Enoch36Yi/FumeHoods/previews/SashSense_node1_schematic.jpg

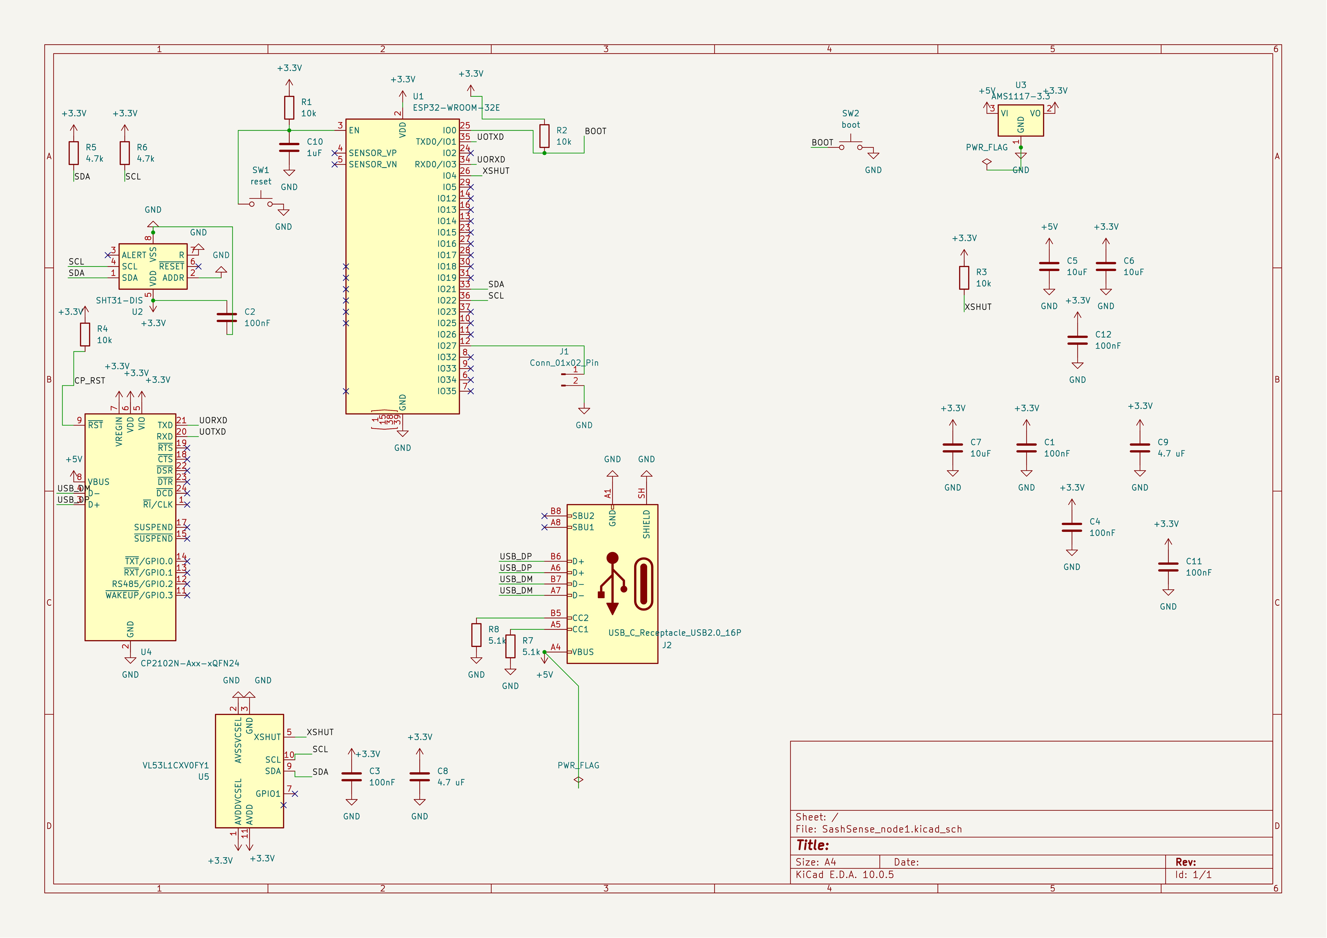
previews/SashSense_node1_schematic.jpg
