Enoch36Yi/FumeHoods/previews/SashSense_node2_pcb_3d_full.jpg

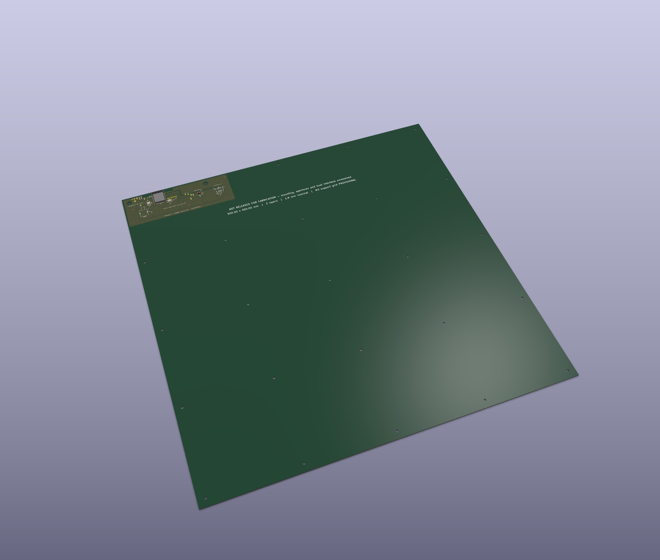
previews/SashSense_node2_pcb_3d_full.jpg
