Enoch36Yi/FumeHoods/previews/SashSense_node2_schematic.jpg

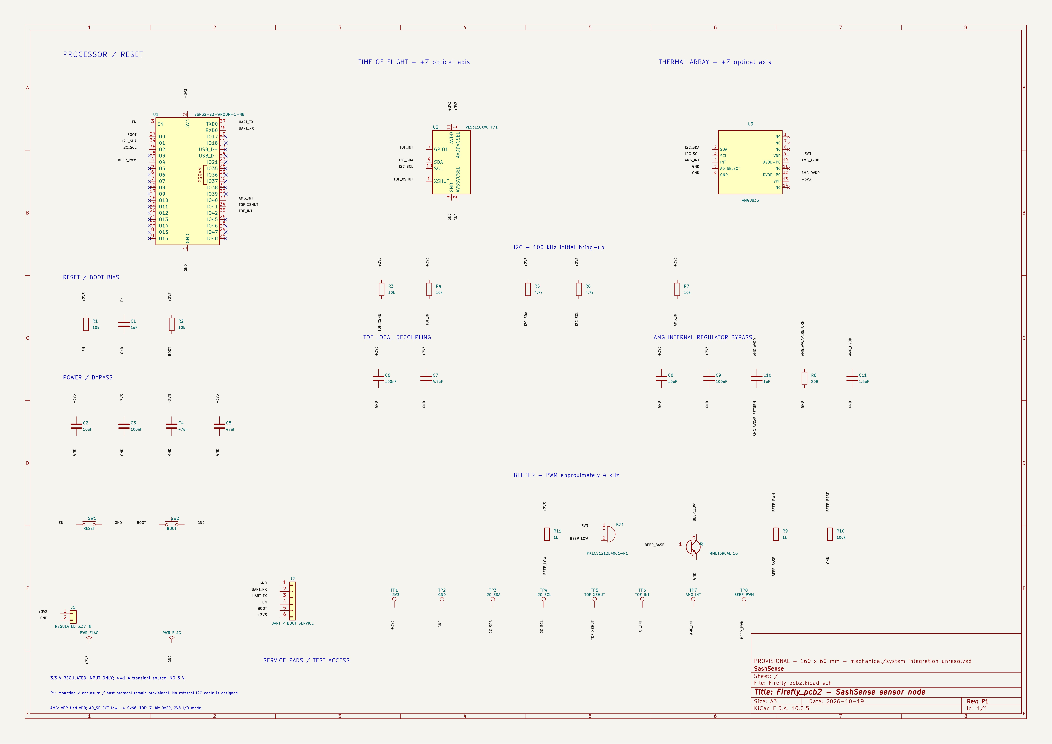
previews/SashSense_node2_schematic.jpg
