Enoch36Yi/FumeHoods/SashSense_node2/outputs/previews/Firefly_pcb2_3D_top_populated.png

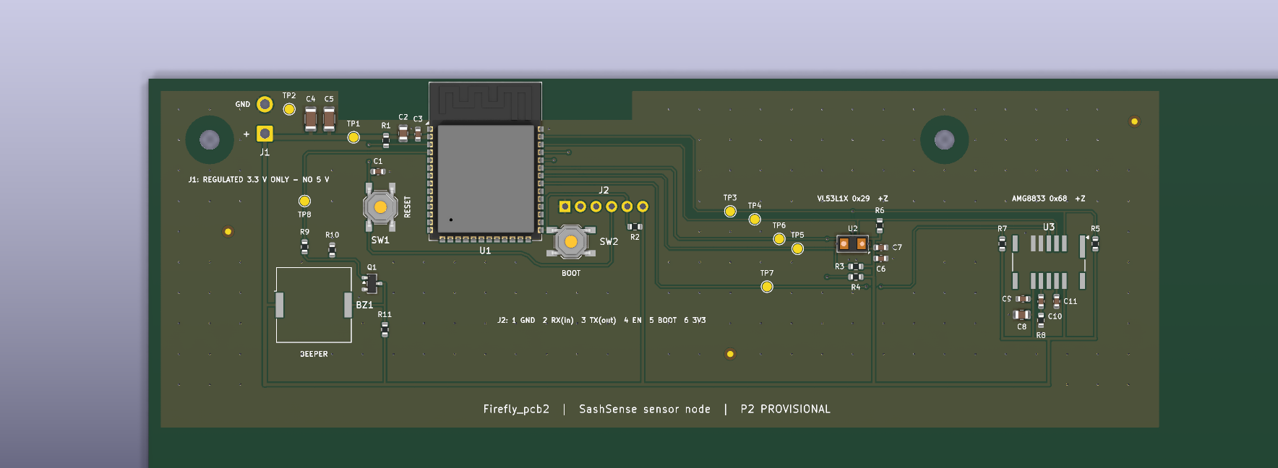
SashSense_node2/outputs/previews/Firefly_pcb2_3D_top_populated.png
