Enoch36Yi/FumeHoods/SashSense_node2/outputs/previews/Firefly_pcb2_copper_bottom.png

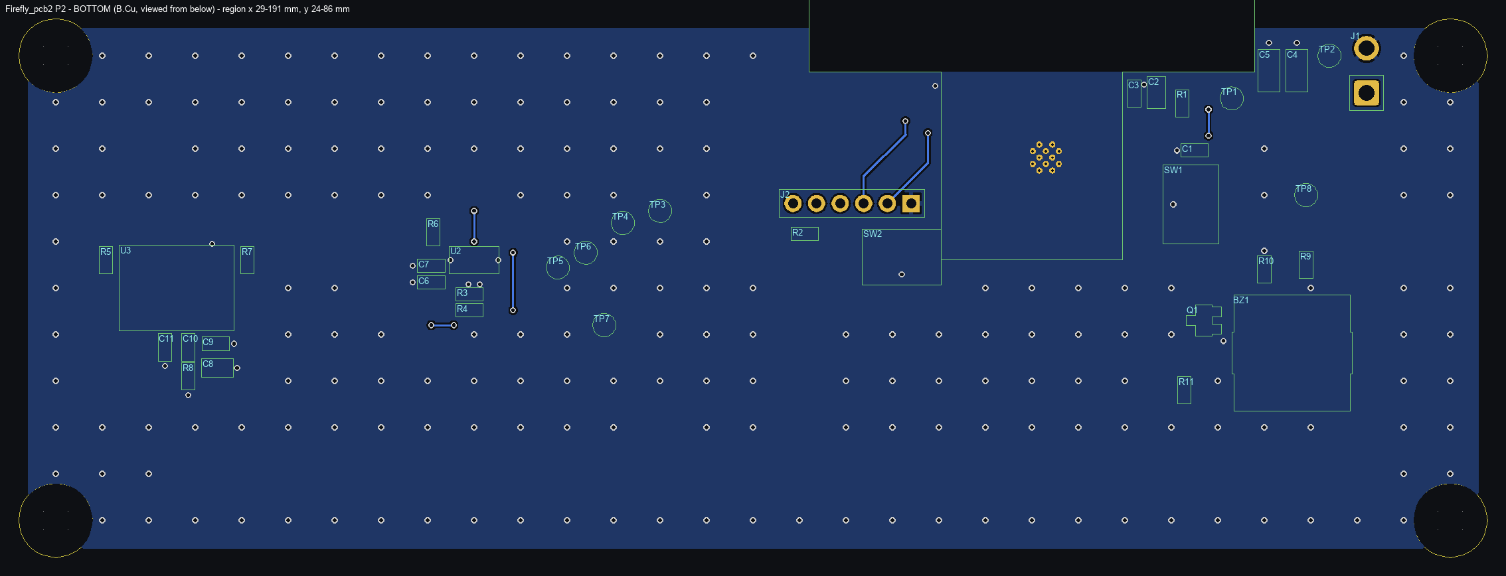
SashSense_node2/outputs/previews/Firefly_pcb2_copper_bottom.png
