Enoch36Yi/FumeHoods/SashSense_node2/outputs/Firefly_pcb2_schematic.pdf

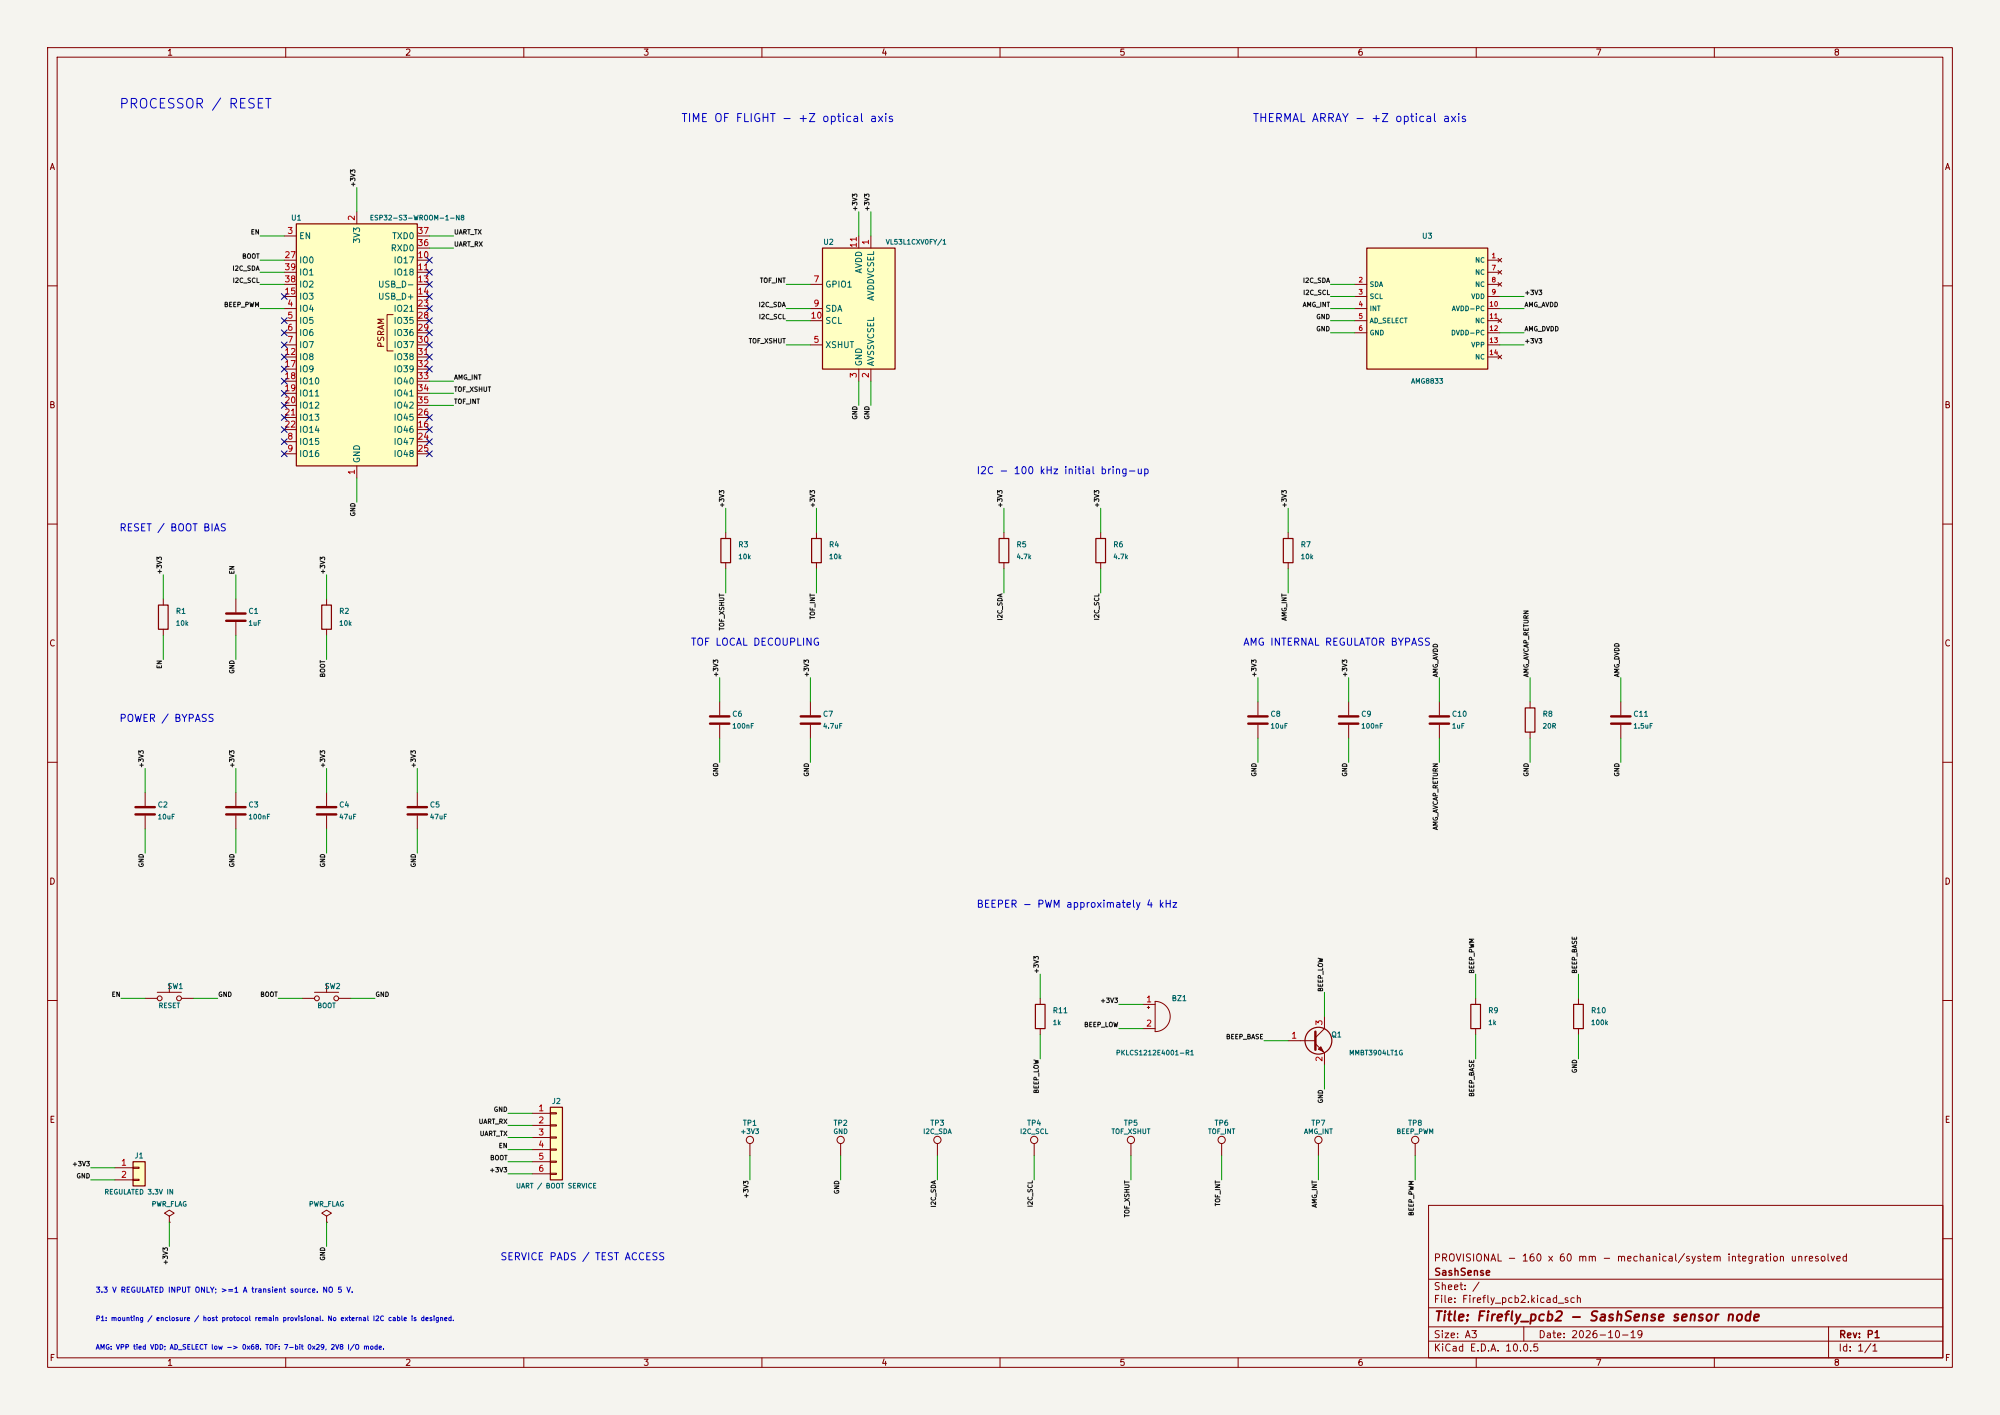
[picture p10: page 1]

TIME OF FLIGHT - +Z optical axis

THERMAL ARRAY - +Z optical axis

I2C - 100 kHz initial bring-up

BEEPER - PWM approximately 4 kHz

SERVICE PADS / TEST ACCESS

PROVISIONAL - 160 x 60 mm - mechanical/system integration unresolved
SashSense
Sheet: /
File: Firefly_pcb2.kicad_sch
Title: Firefly_pcb2 - SashSense sensor node

3.3 V REGULATED INPUT ONLY; >=1 A transient source. NO 5 V. P1: mounting / enclosure / host protocol remain provisional. No external I2C cable is designed. AMG: VPP tied VDD; AD_SELECT low -> 0x68. TOF: 7-bit 0x29, 2V8 I/O mode.

Size: A3 | Rev: P1 | F Date: 2026-10-19
KiCad E.D.A. 10.0.5 | Id: 1/1
