Enoch36Yi/FumeHoods/SashSense_node1.pdf

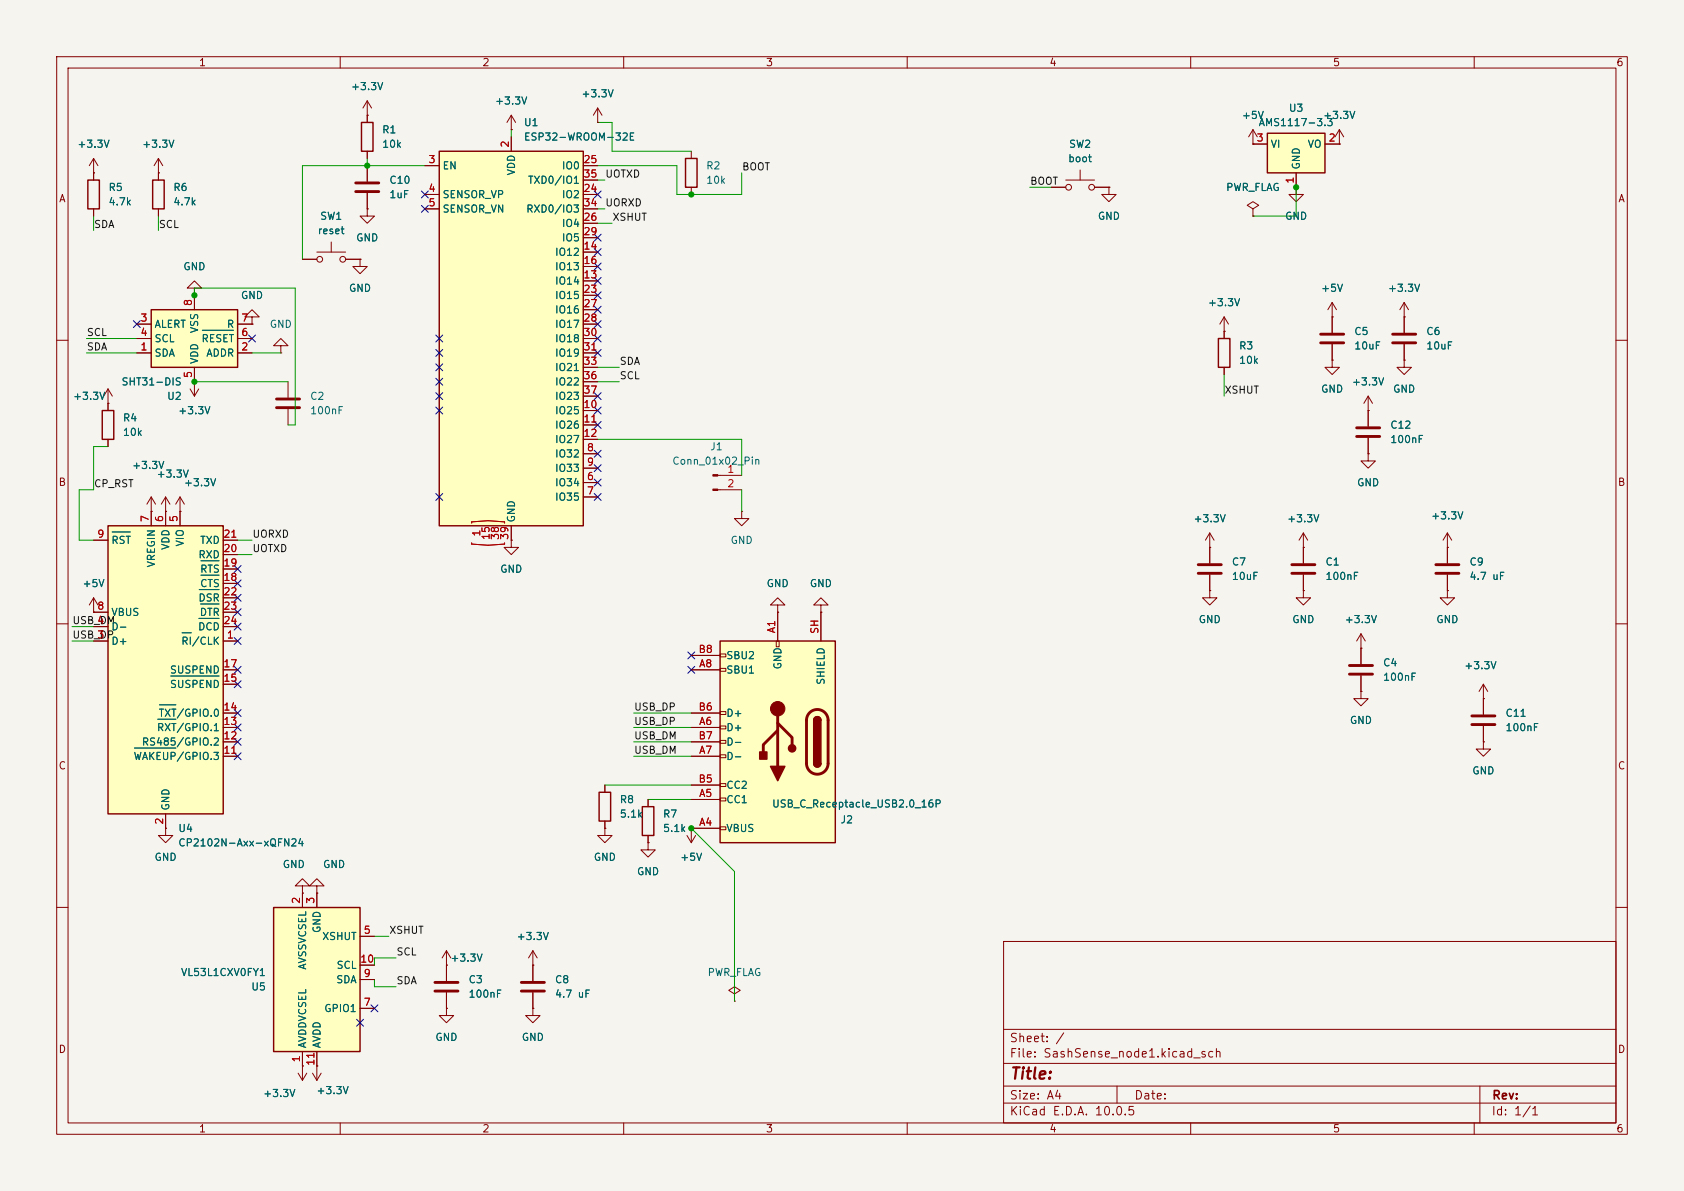
[picture p11: page 1]

Size: A4 | Rev:
KiCad E.D.A. 10.0.5 | Id: 1/1
