Enoch36Yi/FumeHoods/PCB_FUMEHOODS.pdf

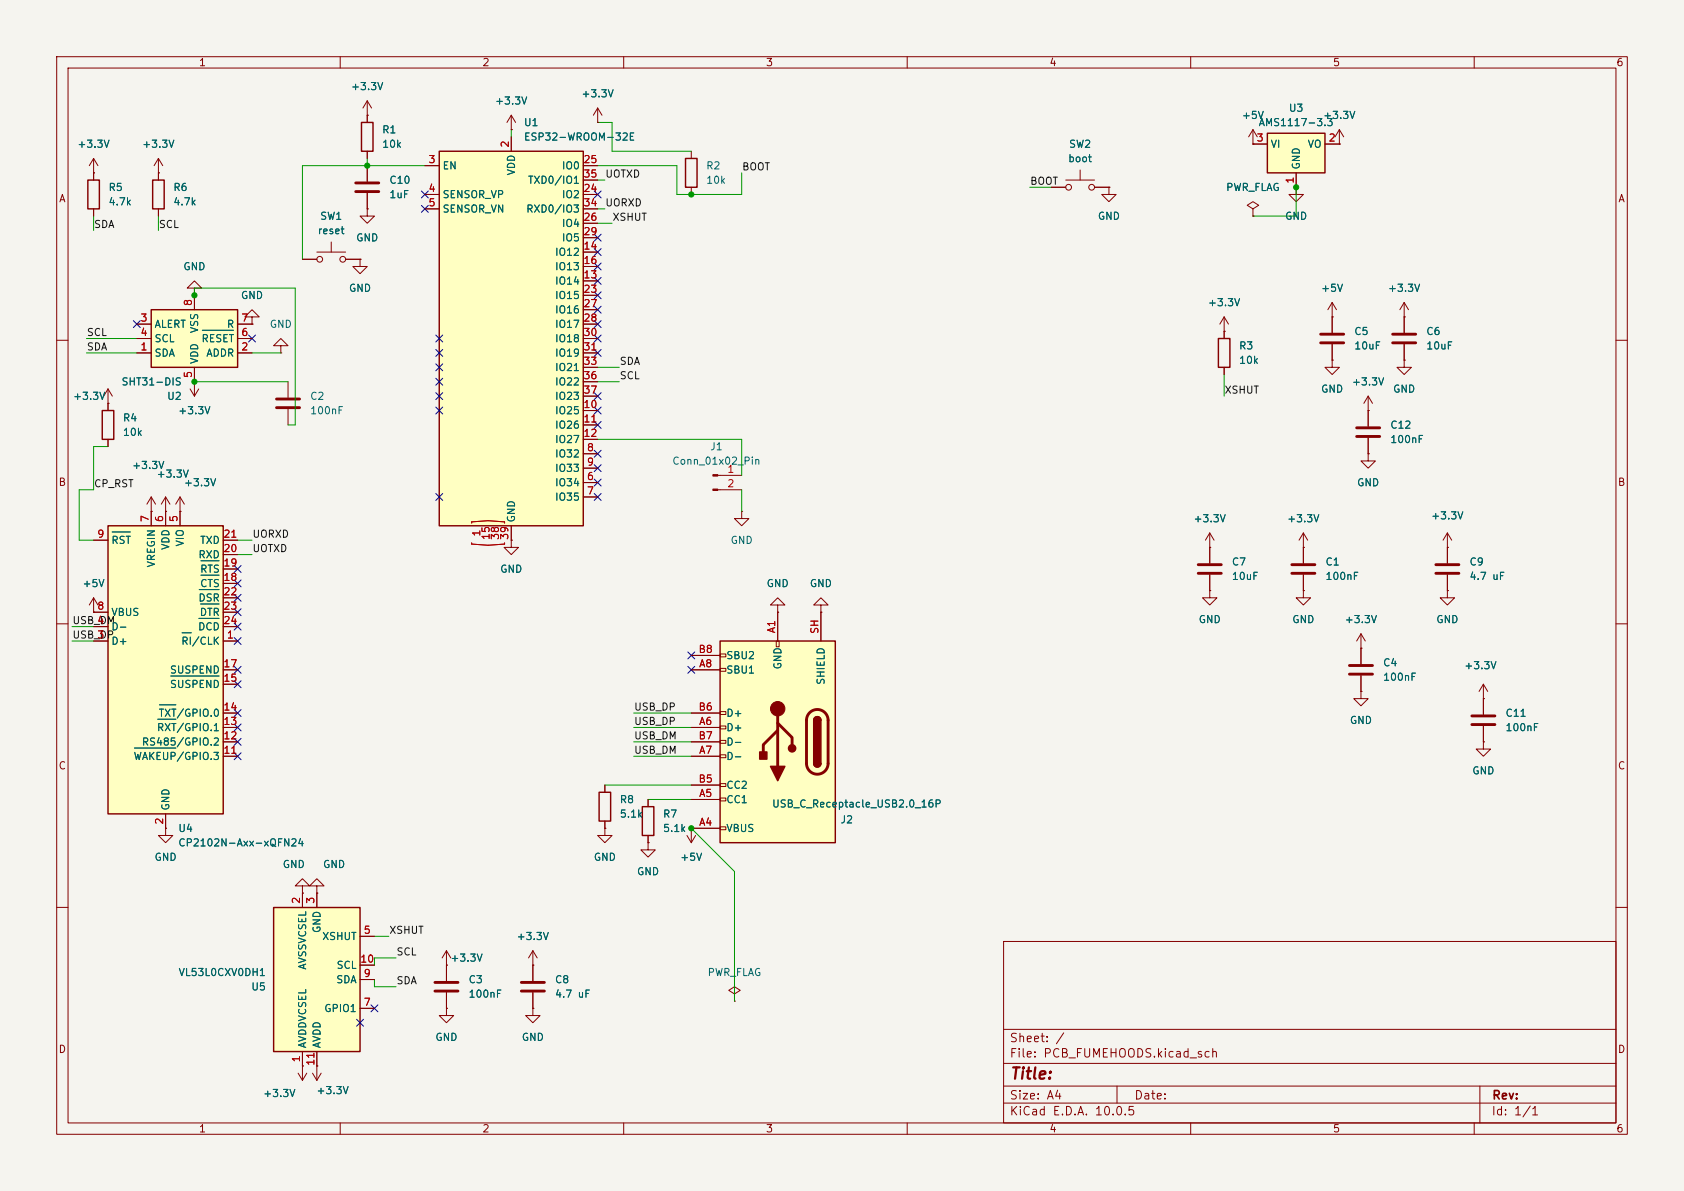
[picture p12: page 1]

Size: A4 | Rev:
KiCad E.D.A. 10.0.5 | Id: 1/1
