Enoch36Yi/FumeHoods/SashSense_node2/outputs/Firefly_pcb2_board_layers.pdf

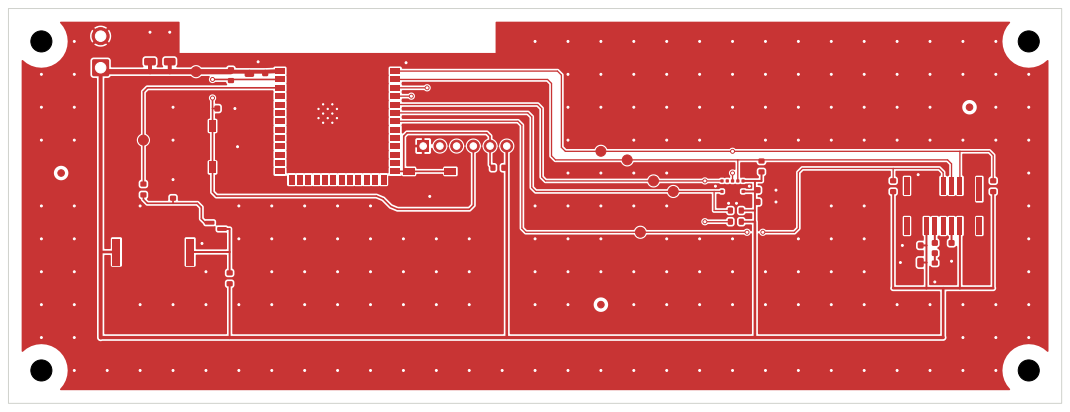
[picture p13: page 1]

160.00 x 60.00 mm, 2 layers, 1.6 mm nominal; mounting/enclosure/host interface unresolved
PROVISIONAL - NOT RELEASED FOR FABRICATION
SashSense
Sheet:
File: Firefly_pcb2.kicad_pcb
Title: Firefly_pcb2 - SashSense sensor node

Size: A4 | Rev: P2
KiCad E.D.A. 10.0.5 | Id: 1/7

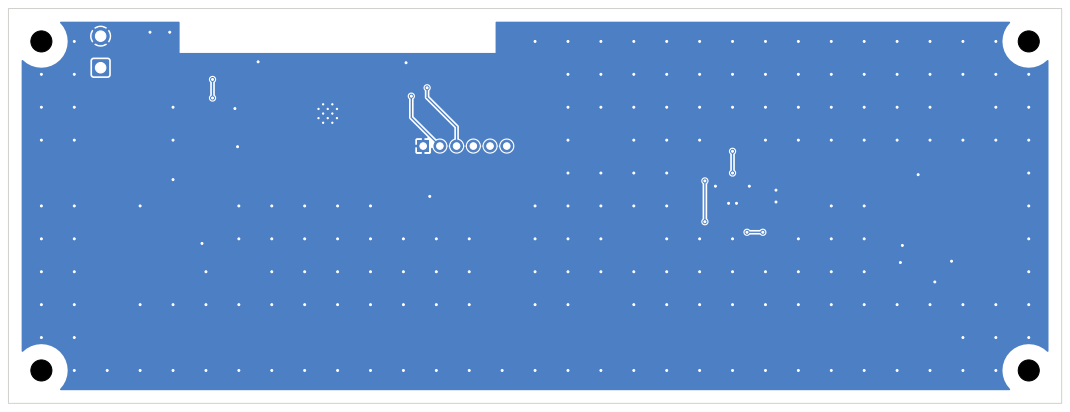
[picture p14: page 2]
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

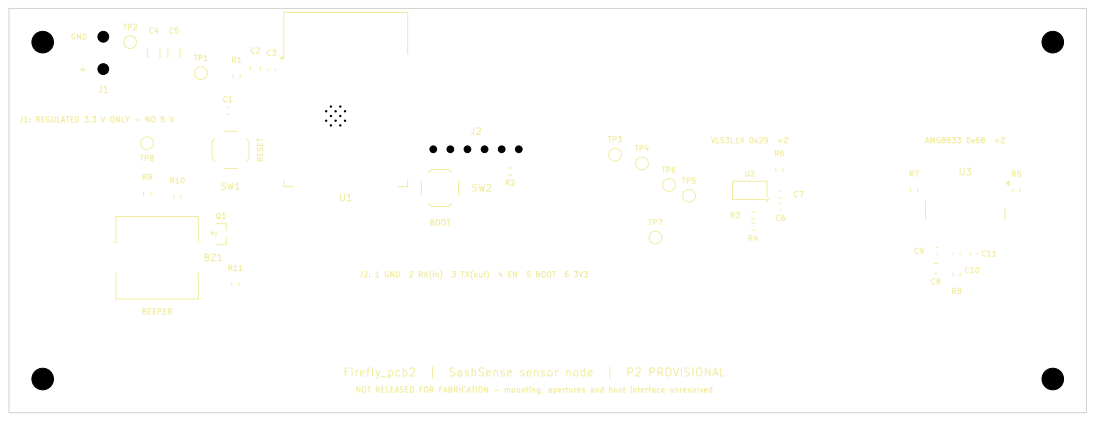
[picture p15: page 3]

J1: REGULATED 3.3 V ONLY - NO 5 V BEEPER

J2: 1 GND 2 RX(in) 3 TX(out) 4 EN 5 BOOT 6 3V3 NOT RELEASED FOR FABRICATION - mounting, apertures and host interface unresolved

Firefly_pcb2 | SashSense sensor node | P2 PROVISIONAL

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

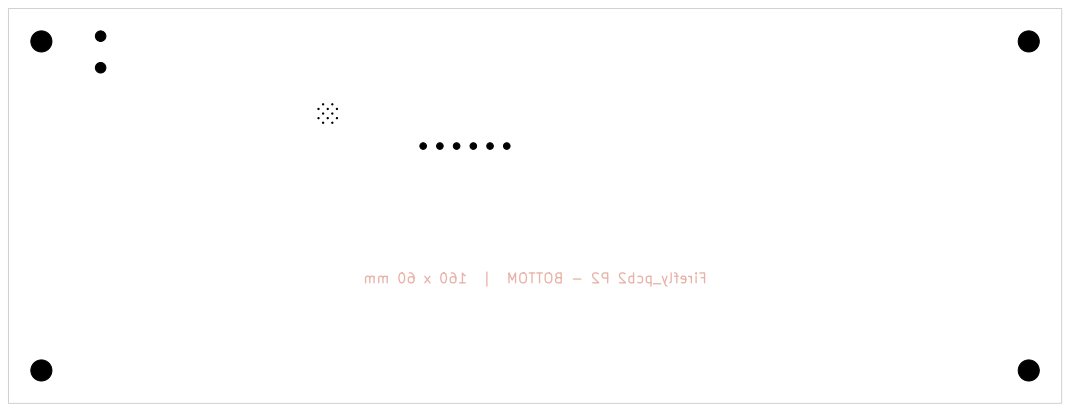
[picture p16: page 4]

PROVISIONAL - NOT RELEASED FOR FABRICATION
SashSense
Sheet:
File: Firefly_pcb2.kicad_pcb
Title: Firefly_pcb2 - SashSense sensor node

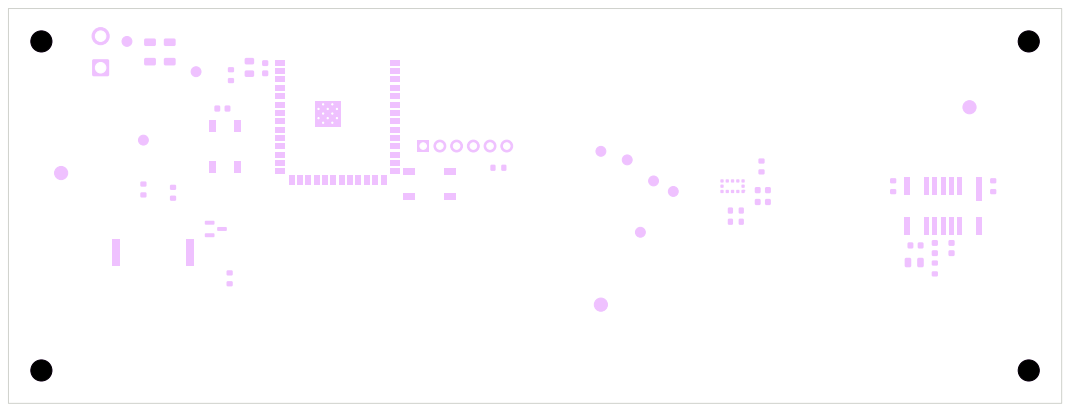
[picture p17: page 5]
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

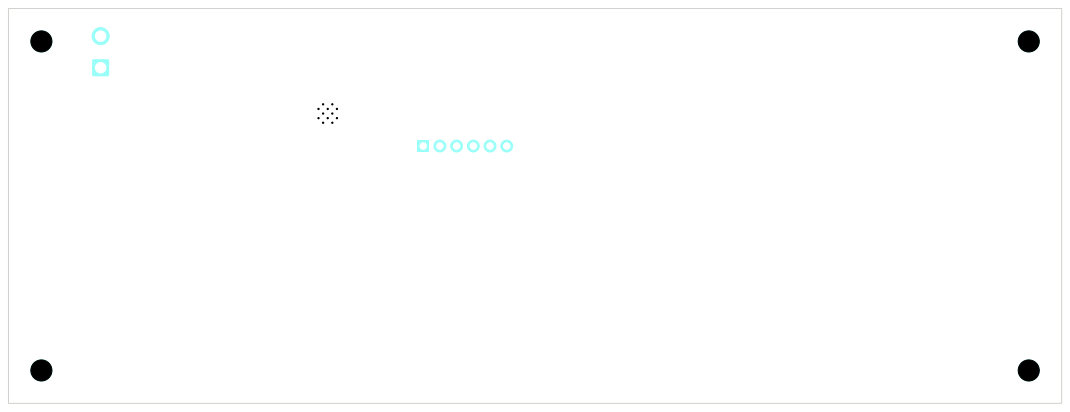
[picture p18: page 6]
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

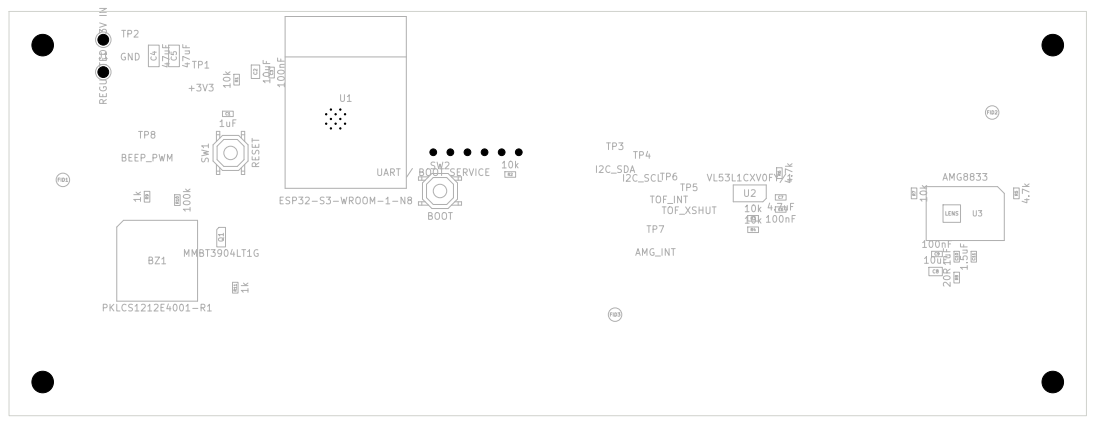
[picture p19: page 7]
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
