Enoch36Yi/FumeHoods/(list of files, drawings)

Other design files:
SashSense_node2/reports/pcb_verification.json
SashSense_node2/reports/schematic_verification.json
