Enoch36Yi/FumeHoods/SashSense_node1.kicad_pcb

## KiCad design SashSense_node1.kicad_pcb (2026-10-20)

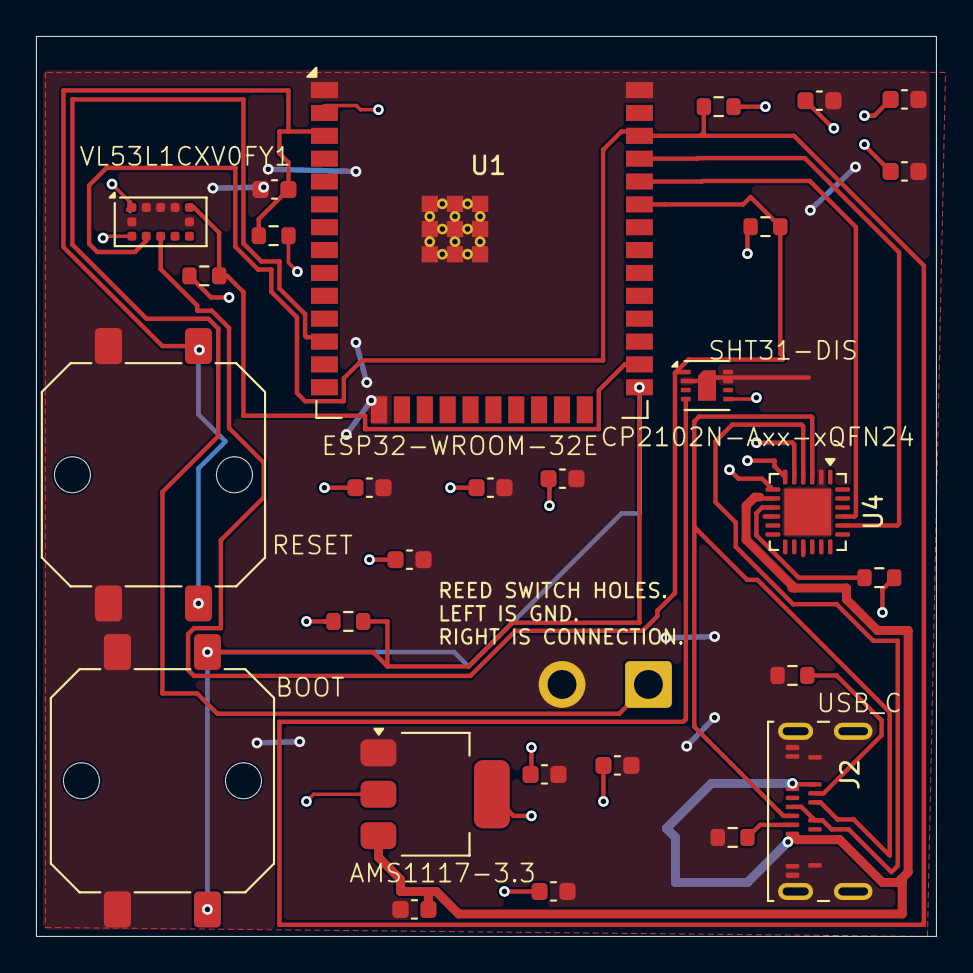
[picture p20: board SashSense_node1.kicad_pcb from above]

Board: 2 copper layers, 50.0 x 50.0 mm, 29 parts (0 on the bottom side), 16 nets.

Parts:
C1, C2, C3, C4, C11, C12: 100nF; C_0603_1608Metric
C5, C6, C7: 10uF; C_0603_1608Metric
C8, C9: 4.7 uF; C_0603_1608Metric
C10: 1uF; C_0603_1608Metric
J1: Conn_01x02_Pin; SolderWire-0.75sqmm_1x02_P4.8mm_D1.25mm_OD2.3mm
J2: USB_C_Receptacle_USB2.0_16P; USB_C_Receptacle_Amphenol_124019772112A
R1, R2, R3, R4: 10k; R_0603_1608Metric
R5, R6: 4.7k; R_0603_1608Metric
R7, R8: 5.1k; R_0603_1608Metric
SW1: reset; SW_Push_1P1T_NO_CK_PTS125Sx43PSMTR
SW2: boot; SW_Push_1P1T_NO_CK_PTS125Sx43PSMTR
U1: ESP32-WROOM-32E
U2: SHT31-DIS; Sensirion_DFN-8-1EP_2.5x2.5mm_P0.5mm_EP1.1x1.7mm
U3: AMS1117-3.3; SOT-223-3_TabPin2
U4: CP2102N-Axx-xQFN24; QFN-24-1EP_4x4mm_P0.5mm_EP2.6x2.6mm
U5: VL53L1CXV0FY1; ST_VL53L1x

Connections:
+3.3V: C1.1, C2.1, C3.1, C4.1, C6.1, C7.1, C8.1, C9.1, C11.1, C12.1, R1.1, R2.1, R3.1, R4.1, R5.1, R6.1, U1.2 (VDD), U2.5 (VDD), U3.2 (VO), U4.5 (VIO), U4.6 (VDD), U4.7 (VREGIN), U5.1 (AVDDVCSEL), U5.11 (AVDD)
+5V: C5.1, J2.A4 (VBUS), J2.A9 (VBUS), J2.B4 (VBUS), J2.B9 (VBUS), U3.3 (VI), U4.8 (VBUS)
/BOOT: R2.2, SW2.1, U1.25 (IO0)
/CP_RST: R4.2, U4.9 (~RST)
/SCL: R6.2, U1.36 (IO22), U2.4 (SCL), U5.10 (SCL)
/SDA: R5.2, U1.33 (IO21), U2.1 (SDA), U5.9 (SDA)
/UORXD: U1.34 (RXD0/IO3), U4.21 (TXD)
/UOTXD: U1.35 (TXD0/IO1), U4.20 (RXD)
/USB_DM: J2.A7 (D-), J2.B7 (D-), U4.4 (D-)
/USB_DP: J2.A6 (D+), J2.B6 (D+), U4.3 (D+)
/XSHUT: R3.2, U1.26 (IO4), U5.5 (XSHUT)
GND: C1.2, C2.2, C3.2, C4.2, C5.2, C6.2, C7.2, C8.2, C9.2, C10.2, C11.2, C12.2, J1.2, J2.A1 (GND), J2.A12 (GND), J2.B1 (GND), J2.B12 (GND), J2.SH (SHIELD), R7.2, R8.2, SW1.2, SW2.2, U1.1 (GND), U1.15 (GND), U1.38 (GND), U1.39 (GND), U2.2 (ADDR), U2.7 (R), U2.8 (VSS), U2.9 (VSS), U3.1 (GND), U4.2 (GND), U4.25 (GND), U5.2 (AVSSVCSEL), U5.3 (GND), U5.4 (GND), U5.6 (GND), U5.12 (GND)
unnamed: J1.1, U1.12 (IO27)
unnamed: J2.A5 (CC1), R7.1
unnamed: J2.B5 (CC2), R8.1
unnamed: C10.1, R1.2, SW1.1, U1.3 (EN)
