Enoch36Yi/FumeHoods/SashSense_node2/Firefly_pcb2.kicad_pcb

## KiCad design SashSense_node2/Firefly_pcb2.kicad_pcb (2026-10-20)

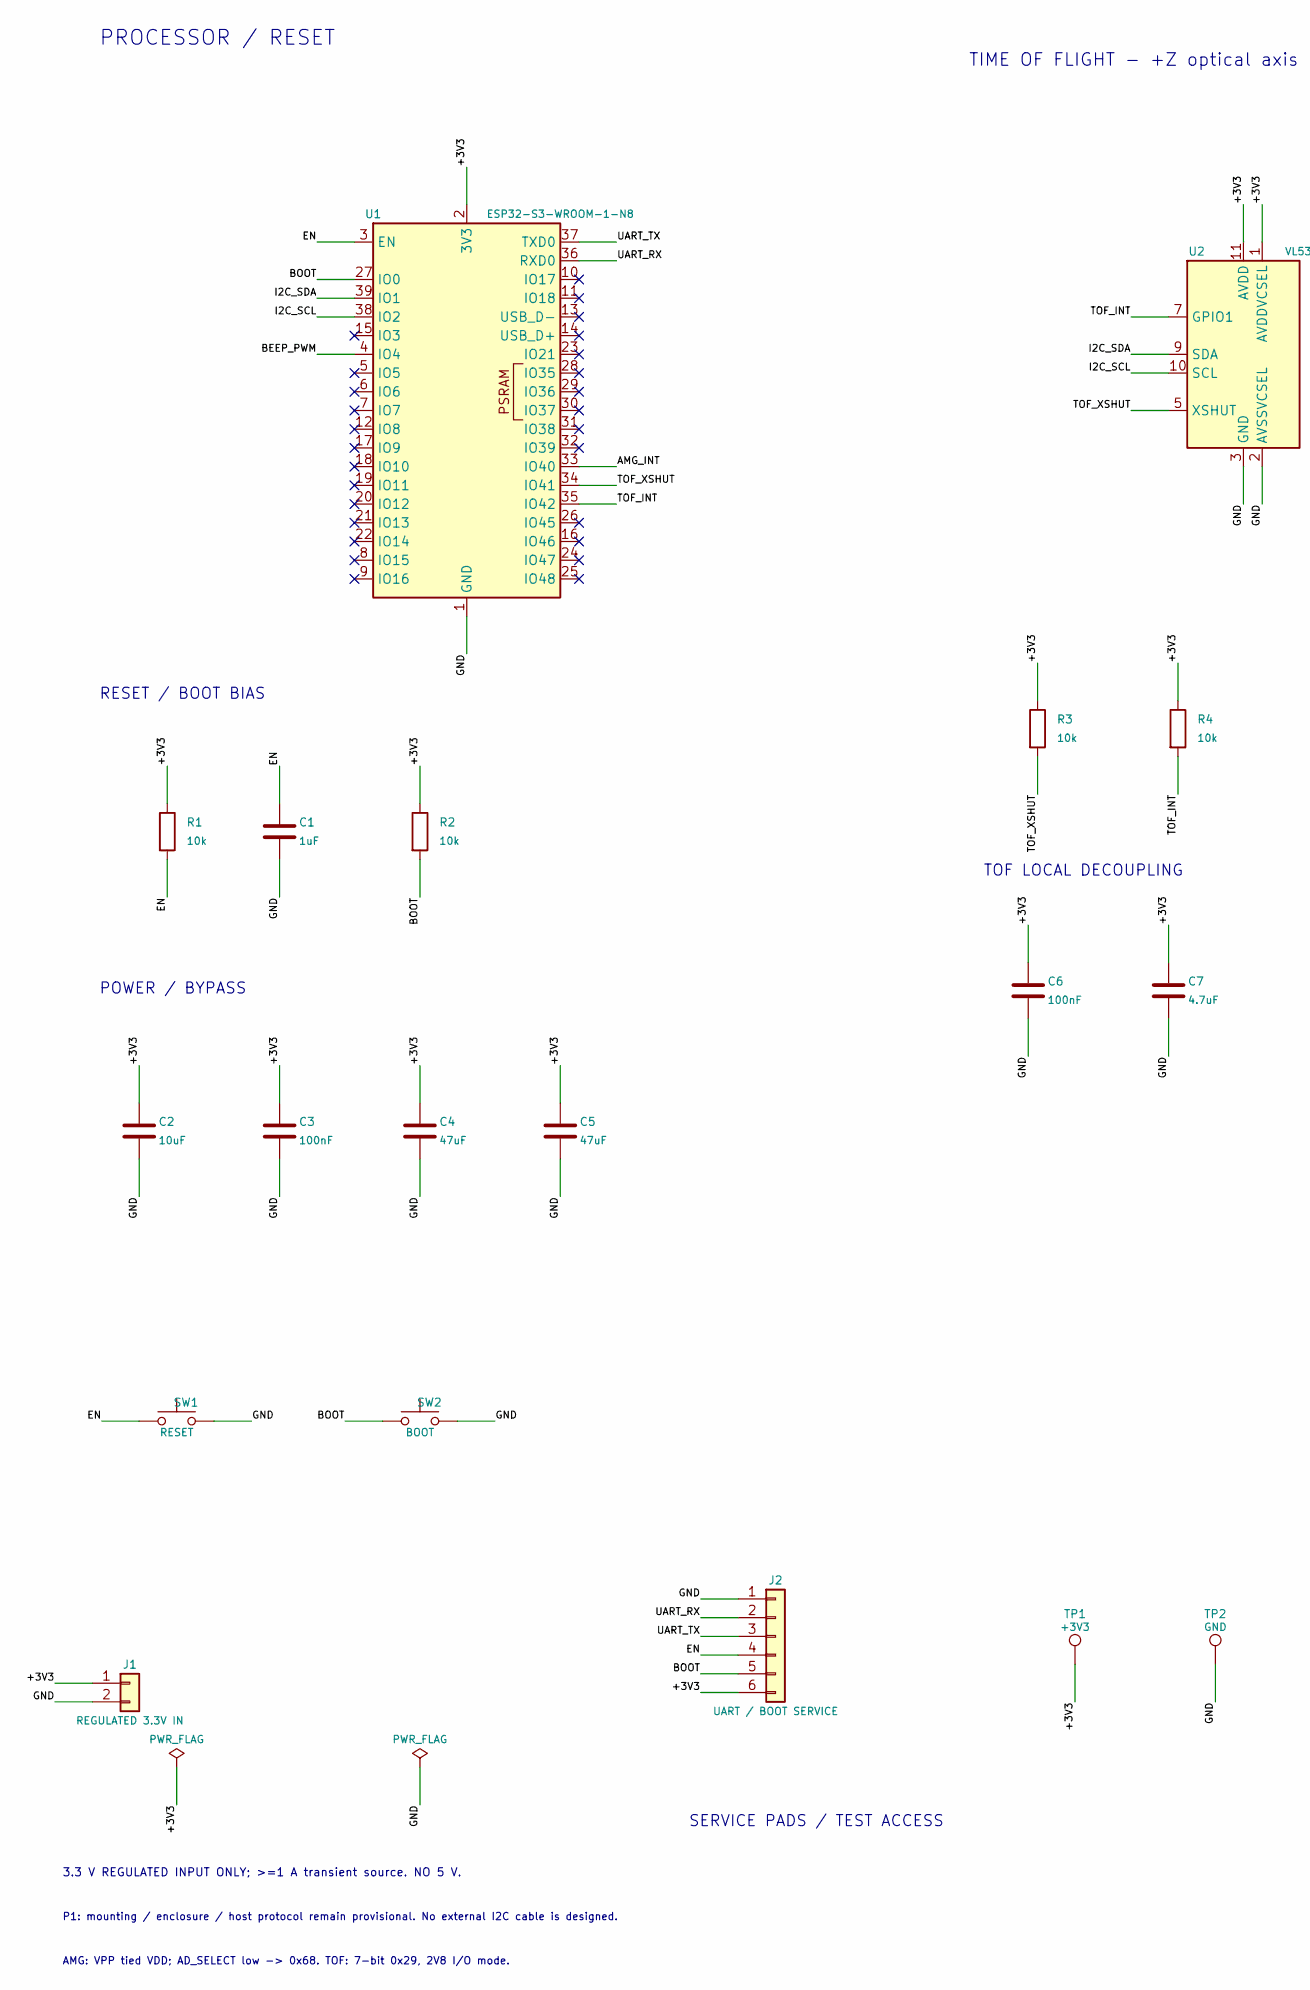
[picture p21: schematic Firefly_pcb2.kicad_sch, Firefly_pcb2 - SashSense sensor node, part in row 1, column 1]

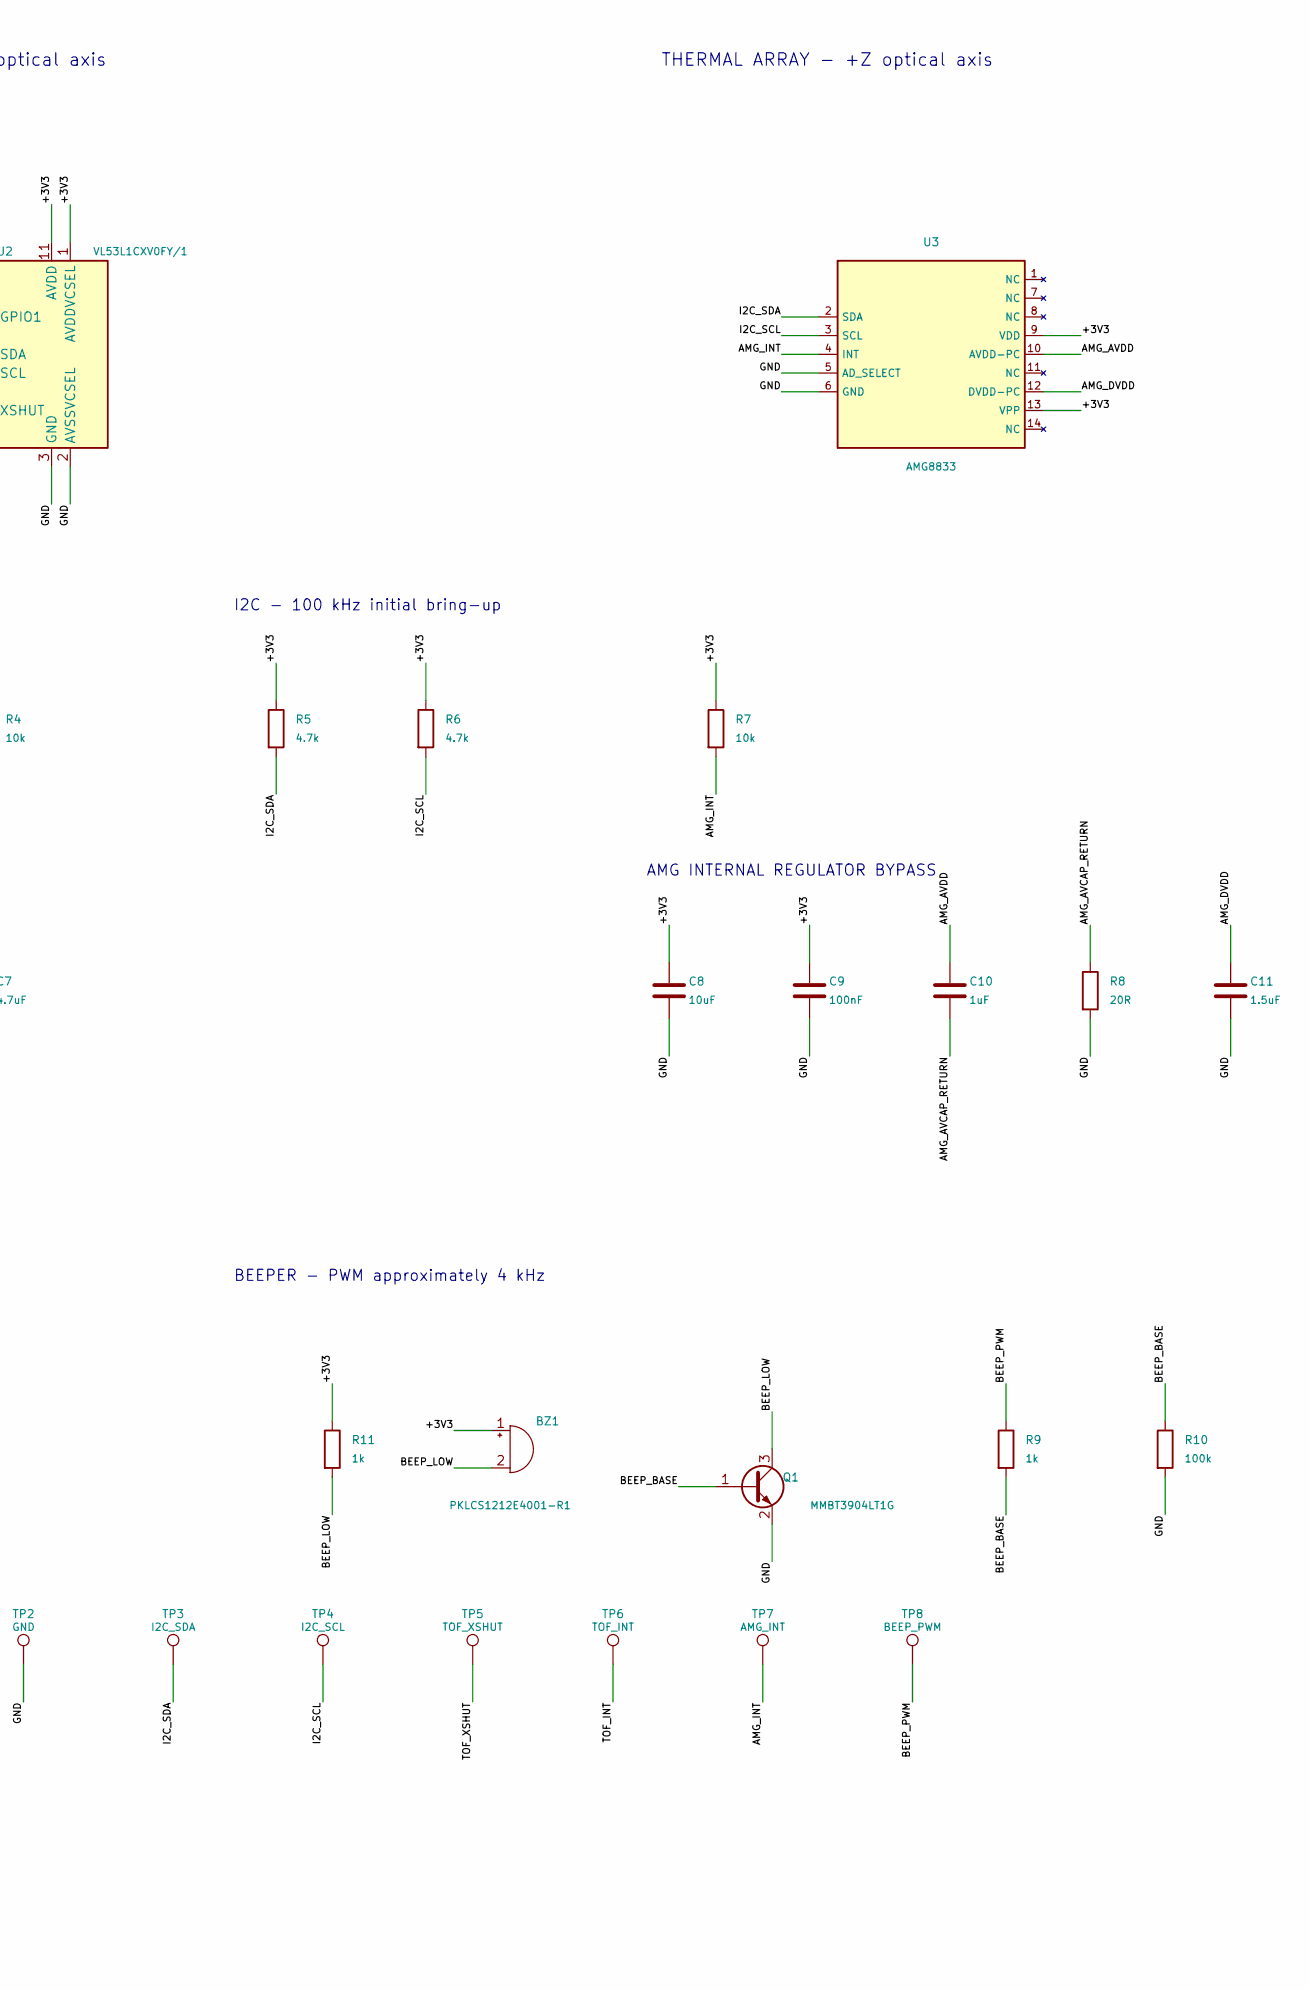
[picture p22: schematic Firefly_pcb2.kicad_sch, Firefly_pcb2 - SashSense sensor node, part in row 1, column 2]

Parts:
BZ1: PKLCS1212E4001-R1; Buzzer_Murata_PKLCS1212E; MPN PKLCS1212E4001-R1
C1, C10: 1uF; C_0603_1608Metric; MPN GRM188R61A105KA61D
C2, C8: 10uF; C_0805_2012Metric; MPN GRM21BR61A106KE19L
C3, C6, C9: 100nF; C_0603_1608Metric; MPN GRM188R71C104KA01D
C4, C5: 47uF; C_1206_3216Metric; MPN GRM31CR60J476ME19L
C7: 4.7uF; C_0603_1608Metric; MPN GRM188R60J475KE19D
C11: 1.5uF; C_0603_1608Metric; MPN GRM188R61A155KA61D
J1: REGULATED 3.3V IN; SolderWire-0.75sqmm_1x02_P4.8mm_D1.25mm_OD2.3mm; MPN PCB FEATURE
J2: UART / BOOT SERVICE; ServicePads_1x06; MPN PCB FEATURE
Q1: MMBT3904LT1G; SOT-23; MPN MMBT3904LT1G
R1, R2, R3, R4, R7: 10k; R_0603_1608Metric; MPN RC0603FR-0710KL
R5, R6: 4.7k; R_0603_1608Metric; MPN RC0603FR-074K7L
R8: 20R; R_0603_1608Metric; MPN RC0603FR-0720RL
R9, R11: 1k; R_0603_1608Metric; MPN RC0603FR-071KL
R10: 100k; R_0603_1608Metric; MPN RC0603FR-07100KL
SW1: RESET; SW_SPST_TL3342; MPN TL3342F160QG
SW2: BOOT; SW_SPST_TL3342; MPN TL3342F160QG
TP1: +3V3; TestPoint_Pad_D1.5mm; MPN PCB FEATURE
TP2: GND; TestPoint_Pad_D1.5mm; MPN PCB FEATURE
TP3: I2C_SDA; TestPoint_Pad_D1.5mm; MPN PCB FEATURE
TP4: I2C_SCL; TestPoint_Pad_D1.5mm; MPN PCB FEATURE
TP5: TOF_XSHUT; TestPoint_Pad_D1.5mm; MPN PCB FEATURE
TP6: TOF_INT; TestPoint_Pad_D1.5mm; MPN PCB FEATURE
TP7: AMG_INT; TestPoint_Pad_D1.5mm; MPN PCB FEATURE
TP8: BEEP_PWM; TestPoint_Pad_D1.5mm; MPN PCB FEATURE
U1: ESP32-S3-WROOM-1-N8; ESP32-S3-WROOM-1; MPN ESP32-S3-WROOM-1-N8
U2: VL53L1CXV0FY/1; ST_VL53L1x; MPN VL53L1CXV0FY/1
U3: AMG8833; MPN AMG8833

Connections:
/+3V3: BZ1.1 (+), C2.1, C3.1, C4.1, C5.1, C6.1, C7.1, C8.1, C9.1, J1.1, J2.6, R1.1, R2.1, R3.1, R4.1, R5.1, R6.1, R7.1, R11.1, TP1.1, U1.2 (3V3), U2.1 (AVDDVCSEL), U2.11 (AVDD), U3.9 (VDD), U3.13 (VPP)
/AMG_AVCAP_RETURN: C10.2, R8.1
/AMG_AVDD: C10.1, U3.10 (AVDD-PC)
/AMG_DVDD: C11.1, U3.12 (DVDD-PC)
/AMG_INT: R7.2, TP7.1, U1.33 (IO40), U3.4 (INT)
/BEEP_BASE: Q1.1 (B), R9.2, R10.1
/BEEP_LOW: BZ1.2 (-), Q1.3 (C), R11.2
/BEEP_PWM: R9.1, TP8.1, U1.4 (IO4)
/BOOT: J2.5, R2.2, SW2.1, U1.27 (IO0)
/EN: C1.1, J2.4, R1.2, SW1.1, U1.3 (EN)
/GND: C1.2, C2.2, C3.2, C4.2, C5.2, C6.2, C7.2, C8.2, C9.2, C11.2, J1.2, J2.1, Q1.2 (E), R8.2, R10.2, SW1.2, SW2.2, TP2.1, U1.1 (GND), U1.40 (GND), U1.41 (GND), U2.2 (AVSSVCSEL), U2.3 (GND), U2.4 (GND), U2.6 (GND), U2.12 (GND), U3.5 (AD_SELECT), U3.6 (GND)
/I2C_SCL: R6.2, TP4.1, U1.38 (IO2), U2.10 (SCL), U3.3 (SCL)
/I2C_SDA: R5.2, TP3.1, U1.39 (IO1), U2.9 (SDA), U3.2 (SDA)
/TOF_INT: R4.2, TP6.1, U1.35 (IO42), U2.7 (GPIO1)
/TOF_XSHUT: R3.2, TP5.1, U1.34 (IO41), U2.5 (XSHUT)
/UART_RX: J2.2, U1.36 (RXD0)
/UART_TX: J2.3, U1.37 (TXD0)

Notes on the sheet:
PROCESSOR / RESET
TIME OF FLIGHT - +Z optical axis
THERMAL ARRAY - +Z optical axis
RESET / BOOT BIAS
I2C - 100 kHz initial bring-up
POWER / BYPASS
TOF LOCAL DECOUPLING
AMG INTERNAL REGULATOR BYPASS
BEEPER - PWM approximately 4 kHz
SERVICE PADS / TEST ACCESS
3.3 V REGULATED INPUT ONLY; >=1 A transient source. NO 5 V.
P1: mounting / enclosure / host protocol remain provisional. No external I2C cable is designed.
AMG: VPP tied VDD; AD_SELECT low -> 0x68. TOF: 7-bit 0x29, 2V8 I/O mode.

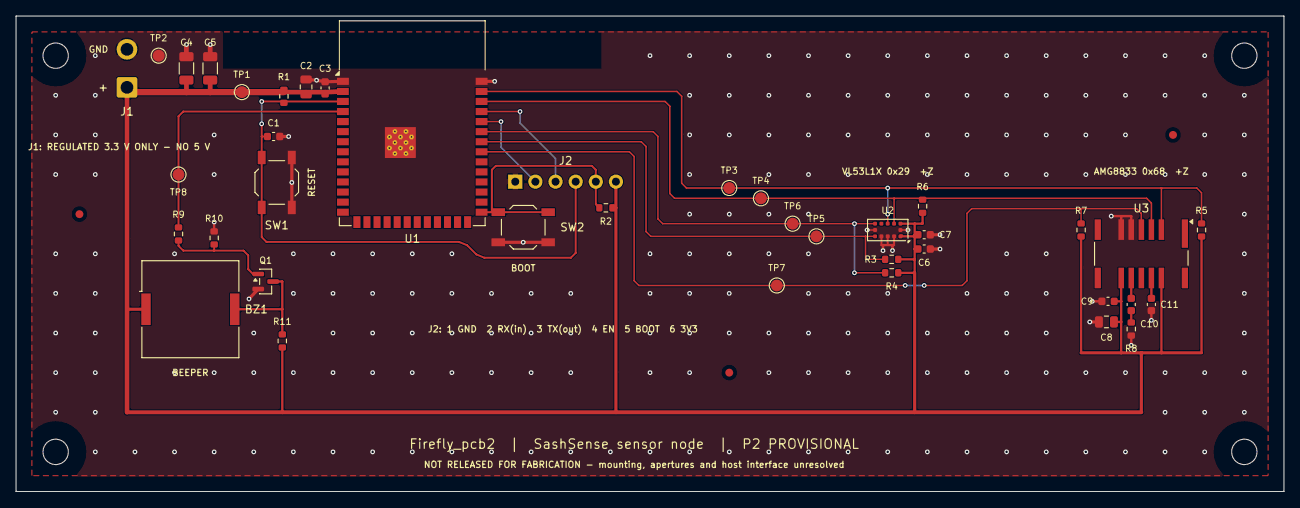
[picture p23: board Firefly_pcb2.kicad_pcb from above]

Board: 2 copper layers, 160.0 x 60.0 mm, 46 parts (0 on the bottom side), 17 nets.

Other parts of the board:
FID1, FID2, FID3: Fiducial; Fiducial_1mm_Mask2mm
H1, H2, H3, H4: M3 SUPPORT - PROVISIONAL; MountingHole_3.2mm_M3
