Enoch36Yi/FumeHoods/(commit log)

2026-10-18 Add original KiCad hardware, previews and recorded rule checks
2026-10-20 Rename Node 1 project and add provisional Firefly presence-board CAD
    Keep the original in-hood CAD byte-identical under SashSense_node1 filenames. Add Firefly native CAD, project-local libraries, builders, previews and verified reports under SashSense_node2. Document the 500 mm provisional outline, unbuilt status, strict metadata findings and fabrication blockers.
2026-10-20 Add schematic JPGs and 3D PCB renders for both SashSense nodes
2026-10-20 Simplify SashSense documentation and clarify board status
2026-10-20 Trim Firefly presence board to 160 x 60 mm
    Cut the unused area from the provisional 500 x 500 mm outline. Placement
    and routing are unchanged; the support grid becomes four corner M3 holes.
    Refresh the native CAD, KiCad check reports, plots, previews and docs.
2026-10-20 Update README with schematics and PCB previews
    Added schematics and PCB previews for Node 1 and Node 2.
2026-10-20 Switch node 1 to VL53L1X and fix its rule-check findings
    Replace the VL53L0X symbol on U5 with the pin-compatible VL53L1X; the board
    already used the VL53L1x footprint. Move SCL and the parallel +5V run off the
    board edge, join the split top ground pour with GND vias and short bottom
    jumpers, rotate C5 so its ground pad reaches the pour, and fix two silkscreen
    warnings. Refresh node 1 reports, PDF, SVG and preview images.
